daniel-carrera/galaxyrvr-rover-build/docs/assets/photos/lidar-adapter-insulation.jpg

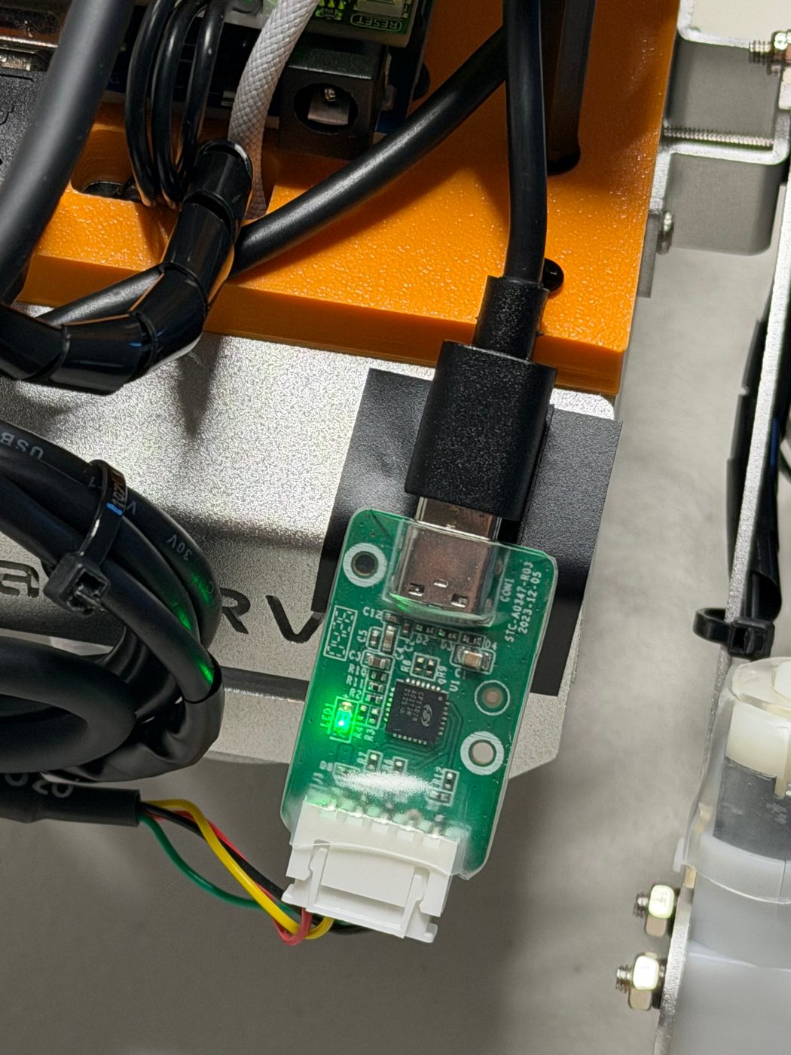
docs/assets/photos/lidar-adapter-insulation.jpg
