daniel-carrera/galaxyrvr-rover-build/docs/assets/photos/nut-pocket-coupon.jpg

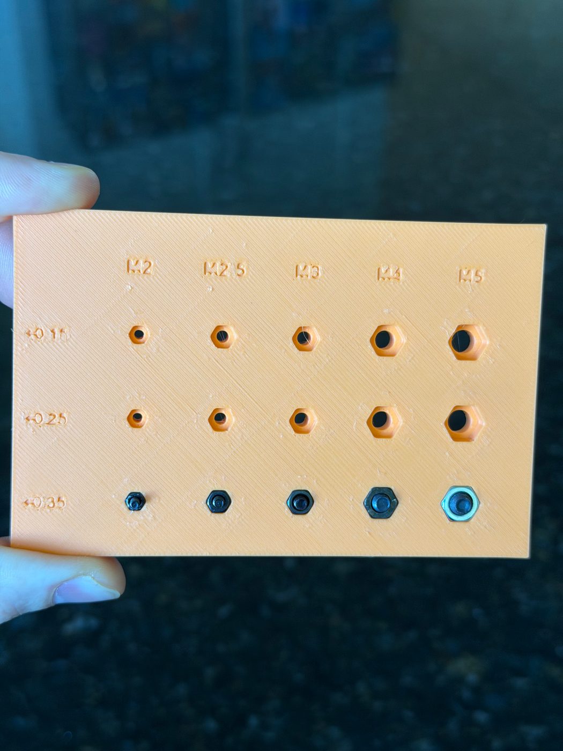
docs/assets/photos/nut-pocket-coupon.jpg
