daniel-carrera/galaxyrvr-rover-build/docs/assets/photos/part-ep-0225.jpg

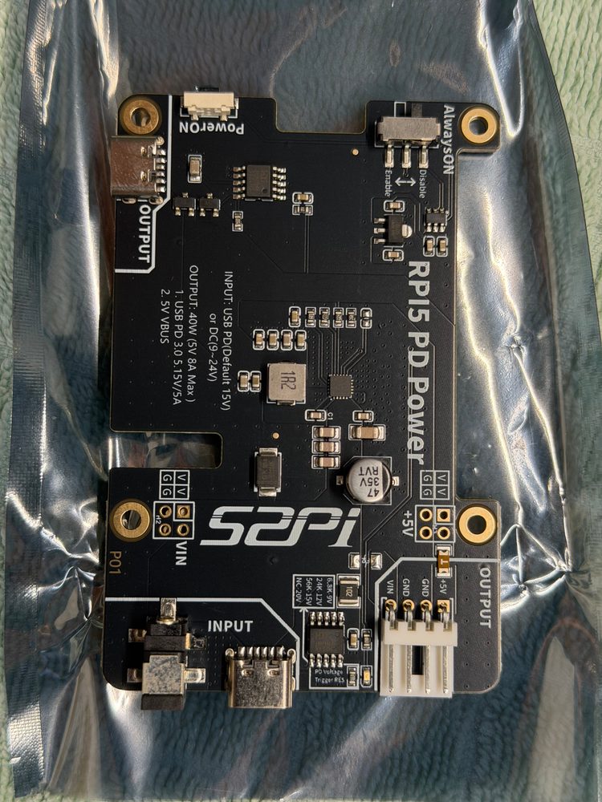
docs/assets/photos/part-ep-0225.jpg
