daniel-carrera/galaxyrvr-rover-build/docs/assets/photos/part-imx708.jpg

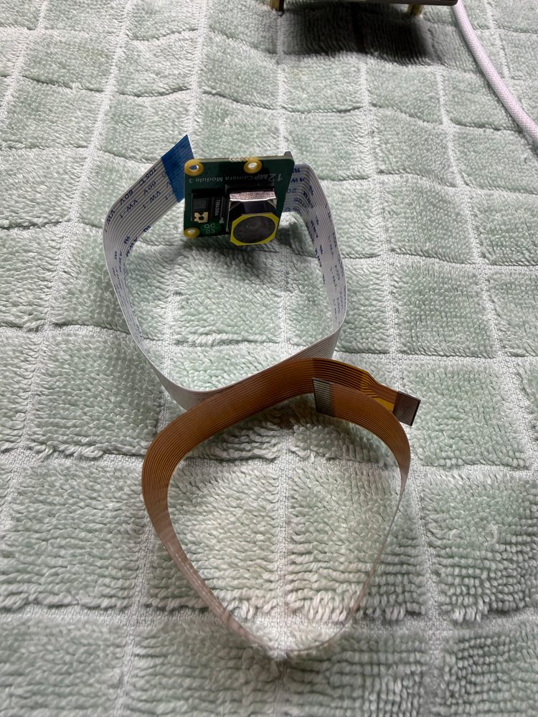
docs/assets/photos/part-imx708.jpg
