daniel-carrera/galaxyrvr-rover-build/docs/assets/photos/part-pi5-cooler.jpg

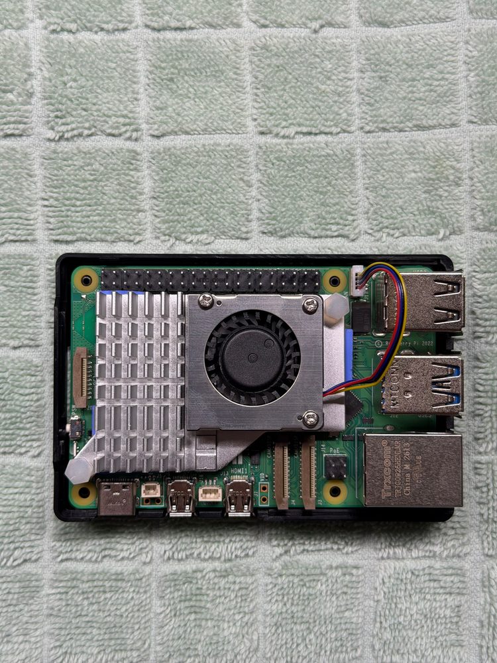
docs/assets/photos/part-pi5-cooler.jpg
