daniel-carrera/galaxyrvr-rover-build/docs/assets/photos/part-r3-board.jpg

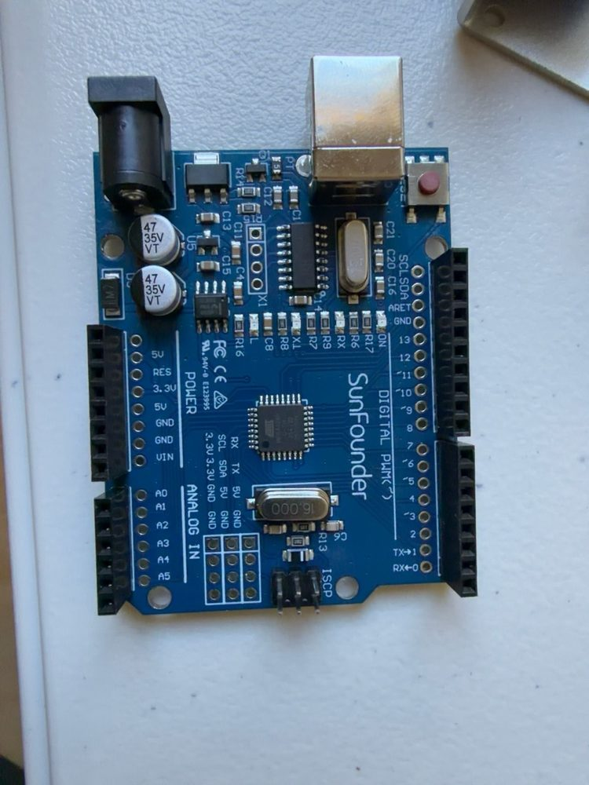
docs/assets/photos/part-r3-board.jpg
