daniel-carrera/galaxyrvr-rover-build/docs/assets/photos/part-rplidar-c1.jpg

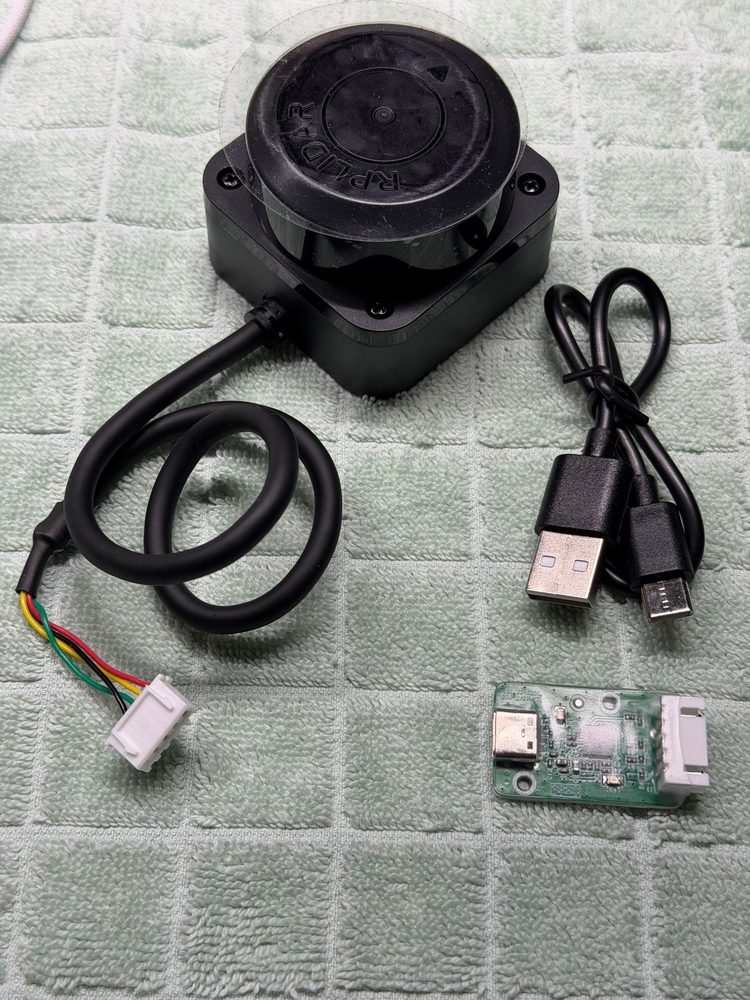
docs/assets/photos/part-rplidar-c1.jpg
