daniel-carrera/galaxyrvr-rover-build/docs/assets/photos/part-shield.jpg

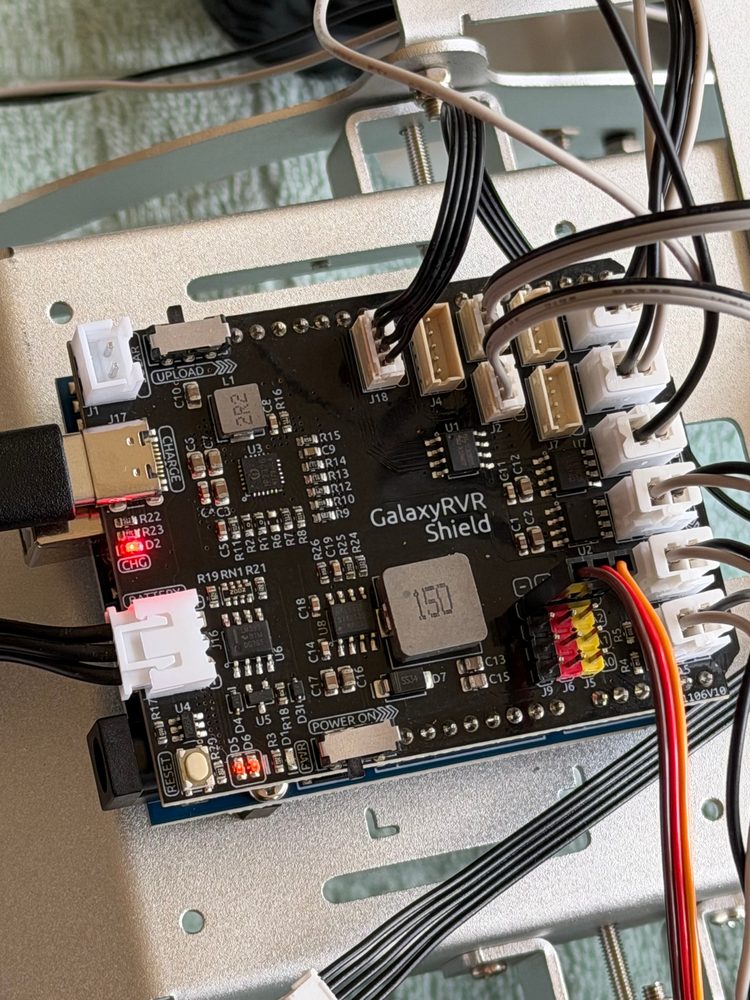
docs/assets/photos/part-shield.jpg
