daniel-carrera/galaxyrvr-rover-build/docs/assets/photos/pi-power-bench.jpg

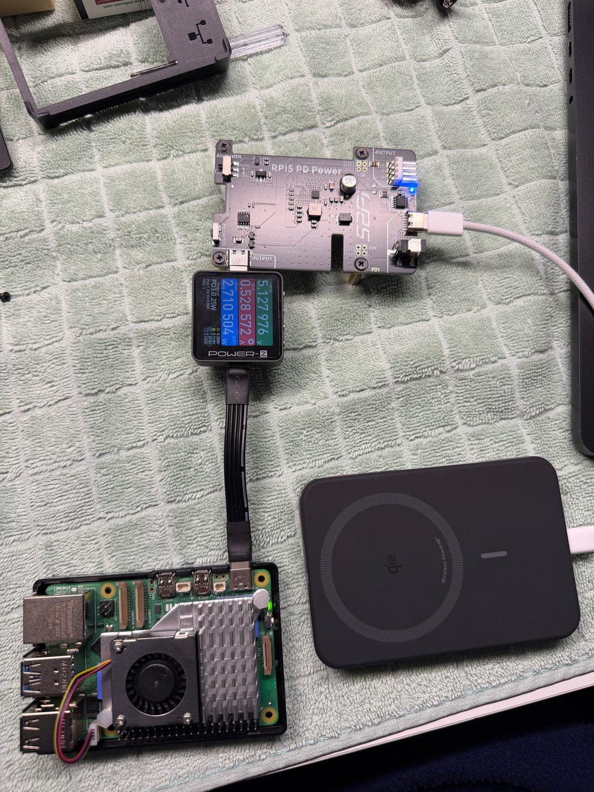
docs/assets/photos/pi-power-bench.jpg
