daniel-carrera/galaxyrvr-rover-build/docs/assets/photos/rover-front.jpg

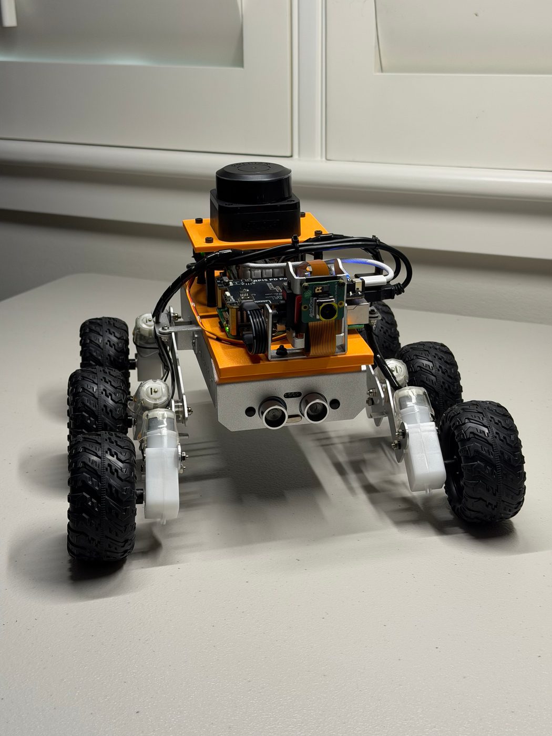
docs/assets/photos/rover-front.jpg
