daniel-carrera/galaxyrvr-rover-build/docs/assets/photos/rover-rear.jpg

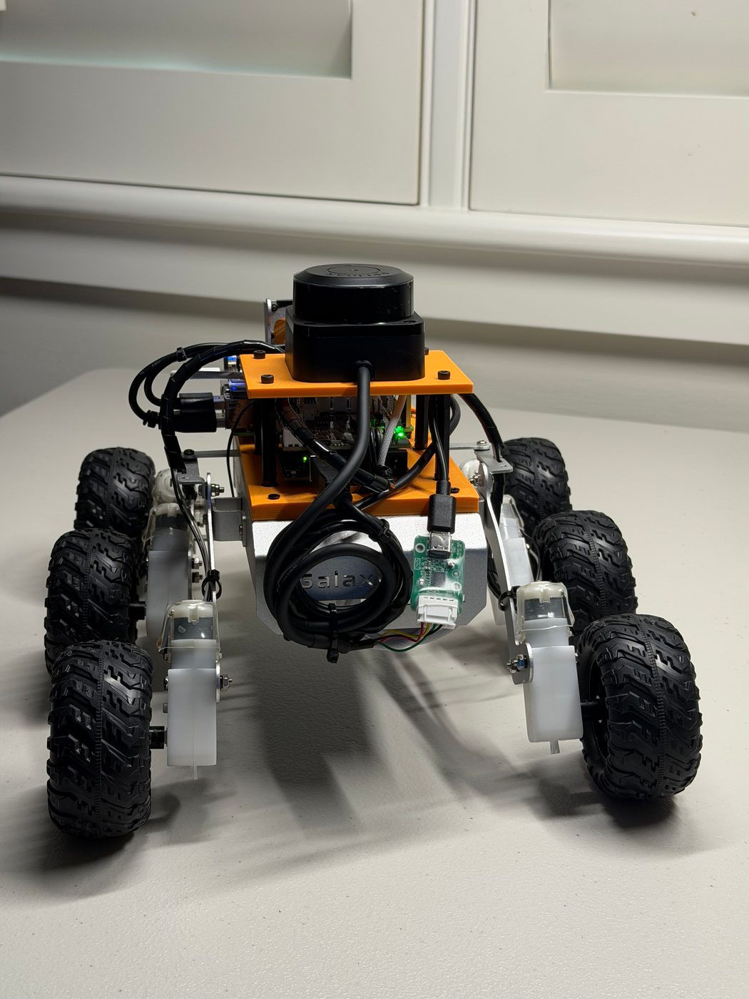
docs/assets/photos/rover-rear.jpg
