daniel-carrera/galaxyrvr-rover-build/docs/assets/photos/stock-rover-top.jpg

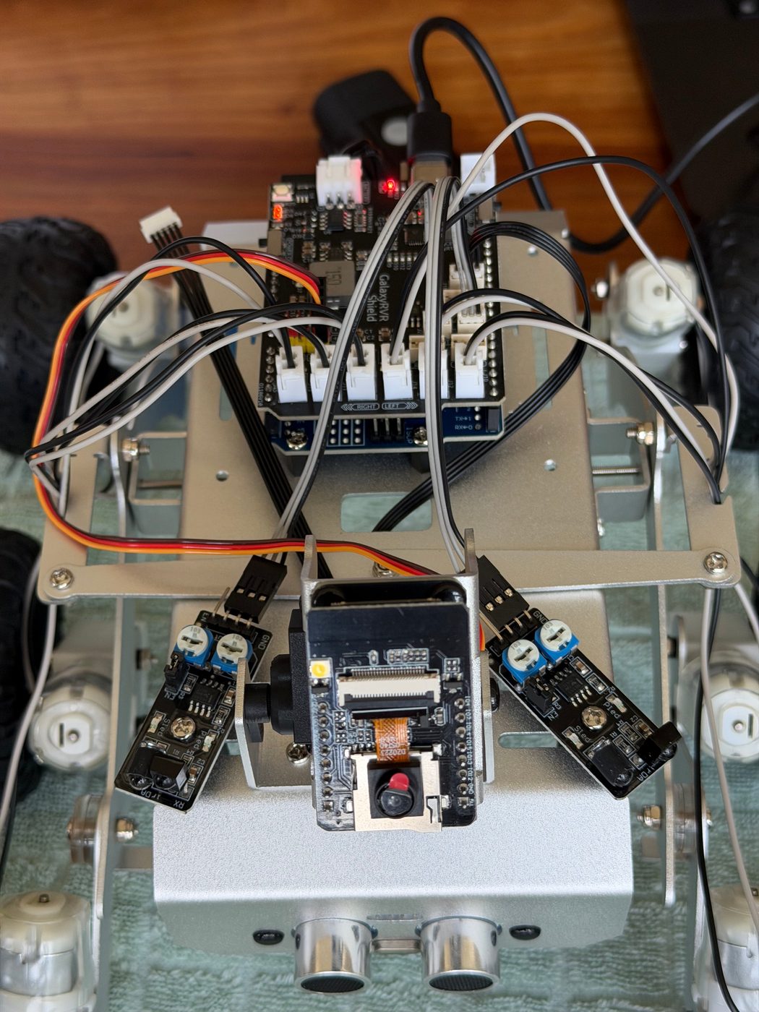
docs/assets/photos/stock-rover-top.jpg
