daniel-carrera/galaxyrvr-rover-build/docs/assets/video/garden-drive-2x.jpg

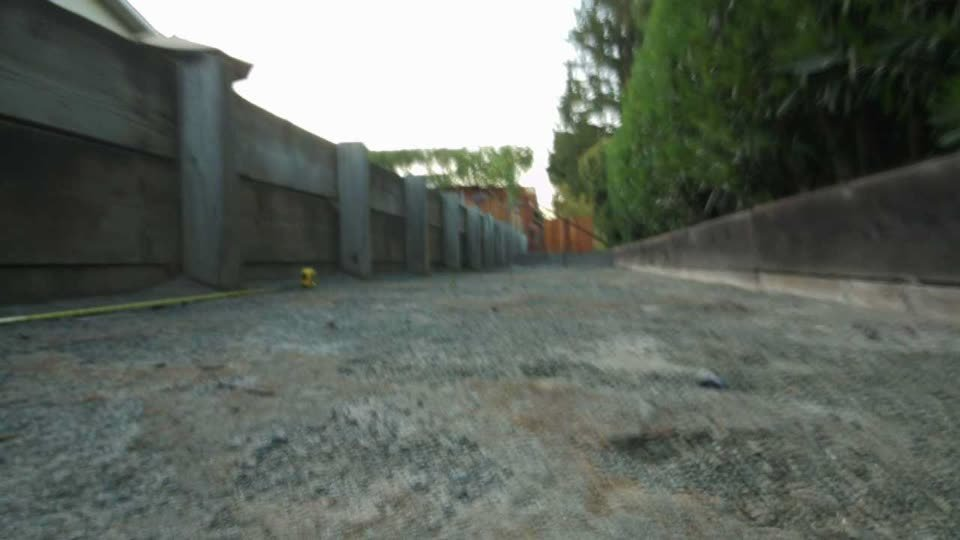
docs/assets/video/garden-drive-2x.jpg
