daniel-carrera/galaxyrvr-rover-build/docs/data/map-2026-09-18.png

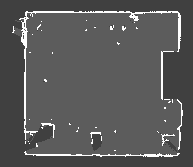
docs/data/map-2026-09-18.png
