daniel-carrera/galaxyrvr-rover-build/cad/step/lidar-carrier.step

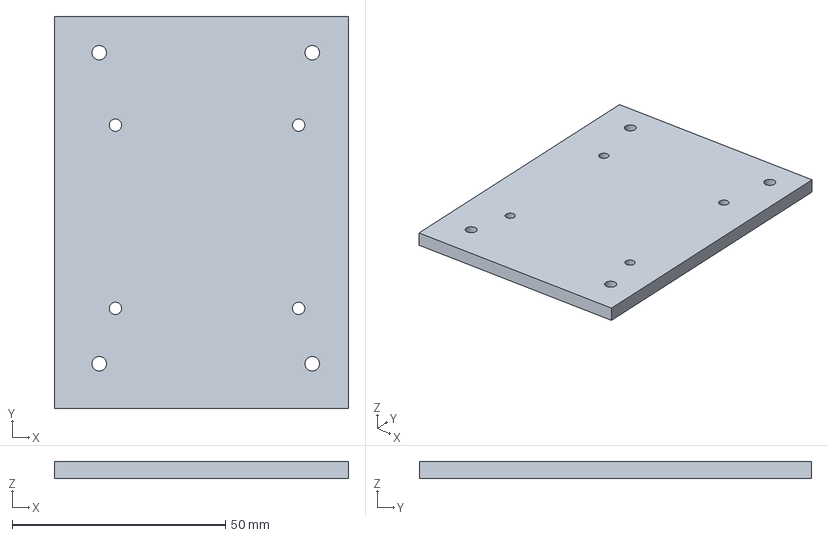
[picture p17: CAD file, 2026-11-10]
cad/step/lidar-carrier.step
69.0 x 92.0 x 4.00 mm
