daniel-carrera/galaxyrvr-rover-build/docs/models/lower-plate.stl

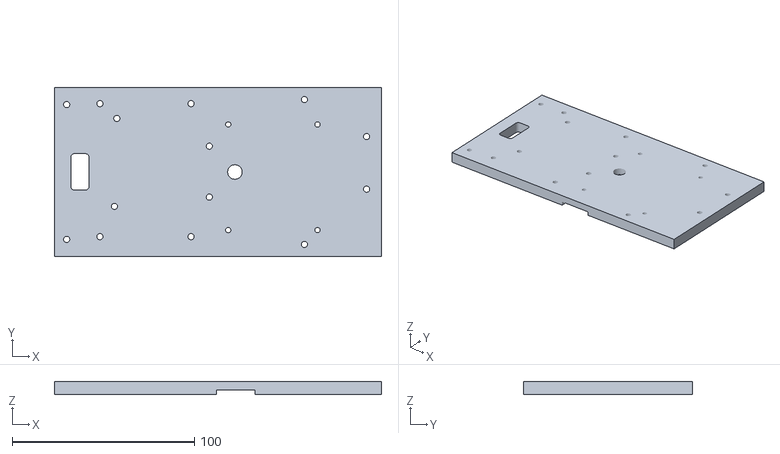
[picture p18: CAD file, 2026-11-10]
docs/models/lower-plate.stl
179.5 x 93.0 x 7.00
