daniel-carrera/galaxyrvr-rover-build/(list of files, cad)

Other CAD files:
cad/step/lower-plate.step
docs/models/lidar-carrier.stl
cad/stl/lidar-carrier.stl
cad/stl/lower-plate.stl
