daniel-carrera/galaxyrvr-rover-build/docs/assets/photos/chassis-measurements.jpg

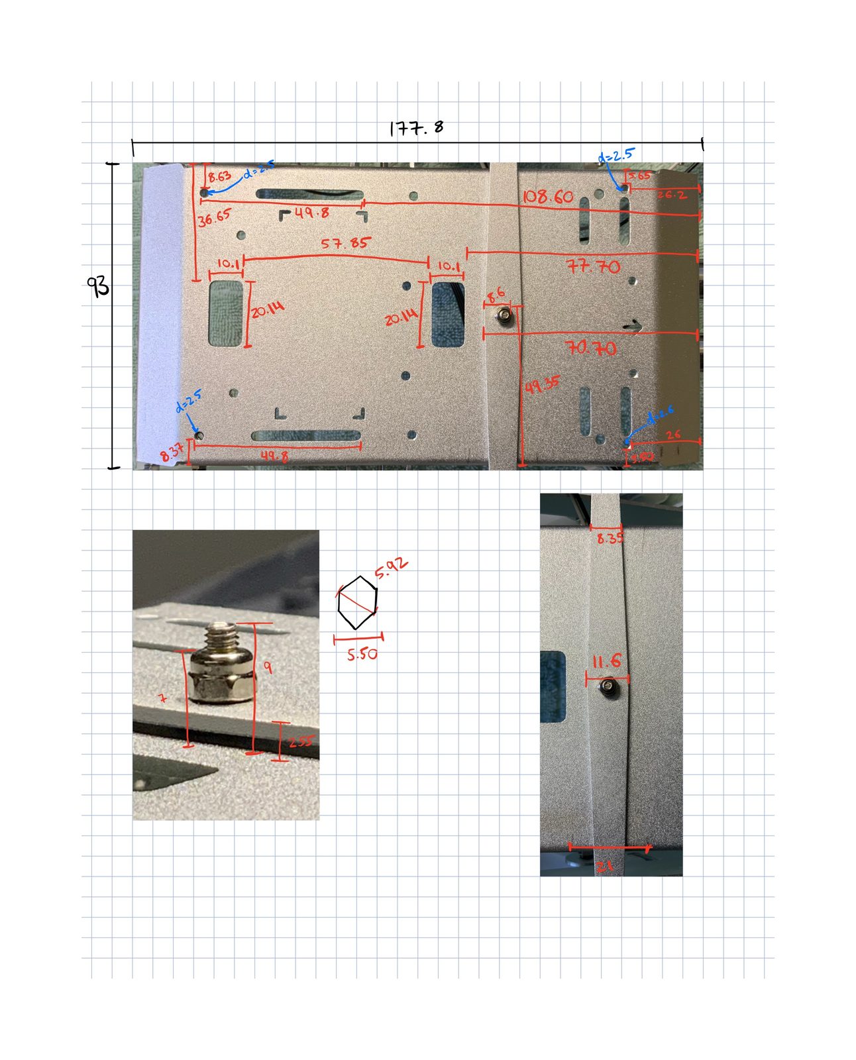
docs/assets/photos/chassis-measurements.jpg
