daniel-carrera/galaxyrvr-rover-build/docs/assets/photos/rover-test-room.jpg

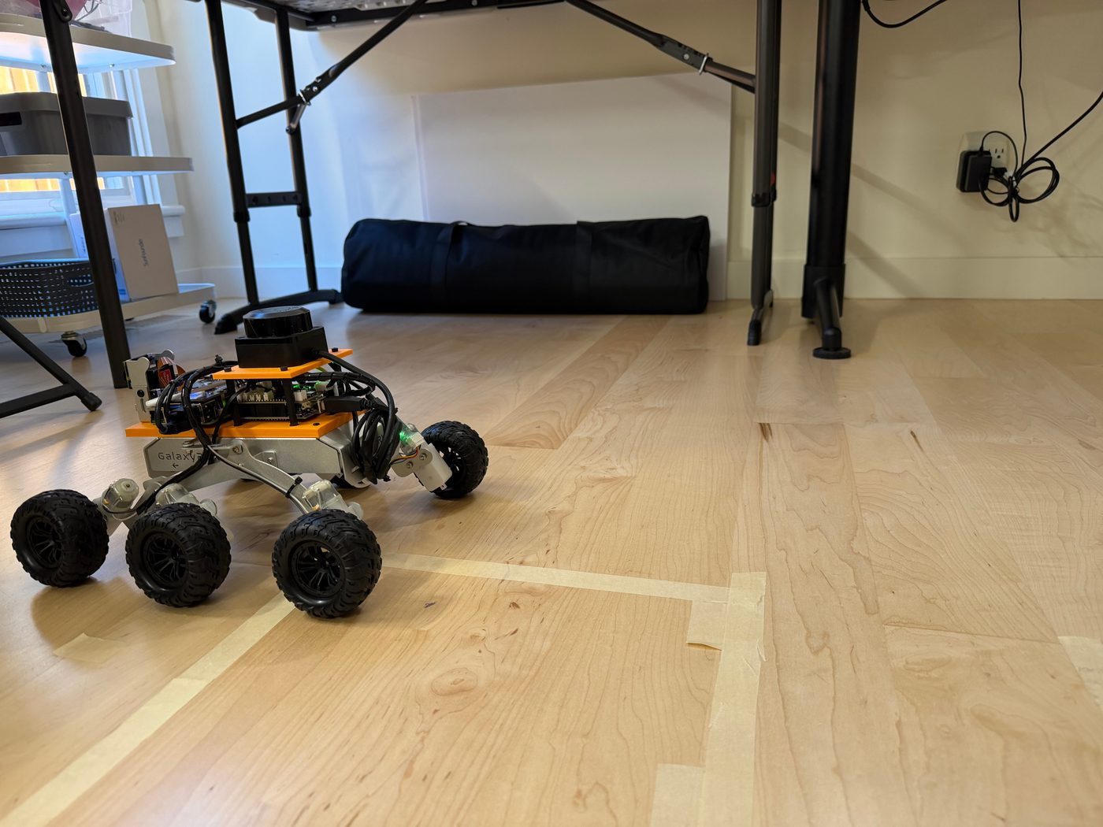
docs/assets/photos/rover-test-room.jpg
