daniel-carrera/galaxyrvr-rover-build/(commit log)

2026-11-10 GalaxyRVR build: project page, printed parts, parts list, assembly
    - docs/: GitHub Pages site with an interactive 3D model of the payload (three.js, vendored)
    - cad/: lower plate and lidar carrier as STL and STEP, rebuilt from the build specification by build_parts.py
    - BOM.md, ASSEMBLY.md (including the VBUS-cut USB cable and how it was checked)
    - Photos re-encoded with all metadata removed
    [lidar-carrier.step, lidar-carrier.stl, lower-plate.step, lower-plate.stl]
2026-11-10 Page: lidar map with the first go-to runs, and the 3D depth map from camera and lidar
    - docs/data/: the 2026-09-18 occupancy grid, mapping drive and three runs; the 2026-09-15 fused point cloud, downsampled to 2 cm
    - docs/js/map2d.js: SVG map with layers, hover readouts and a results table
    - docs/js/depth3d.js: point-cloud viewer with camera or height colouring, lidar slice and path
2026-11-10 Page: restore the content width cap and side margins; narrow content to 64rem
    A style insertion had split the shared header/main/footer rule, so the page ran edge to edge with no side padding.
